danyw/IoT-LED-Controller/assets/led_controller_enclosure_2.png

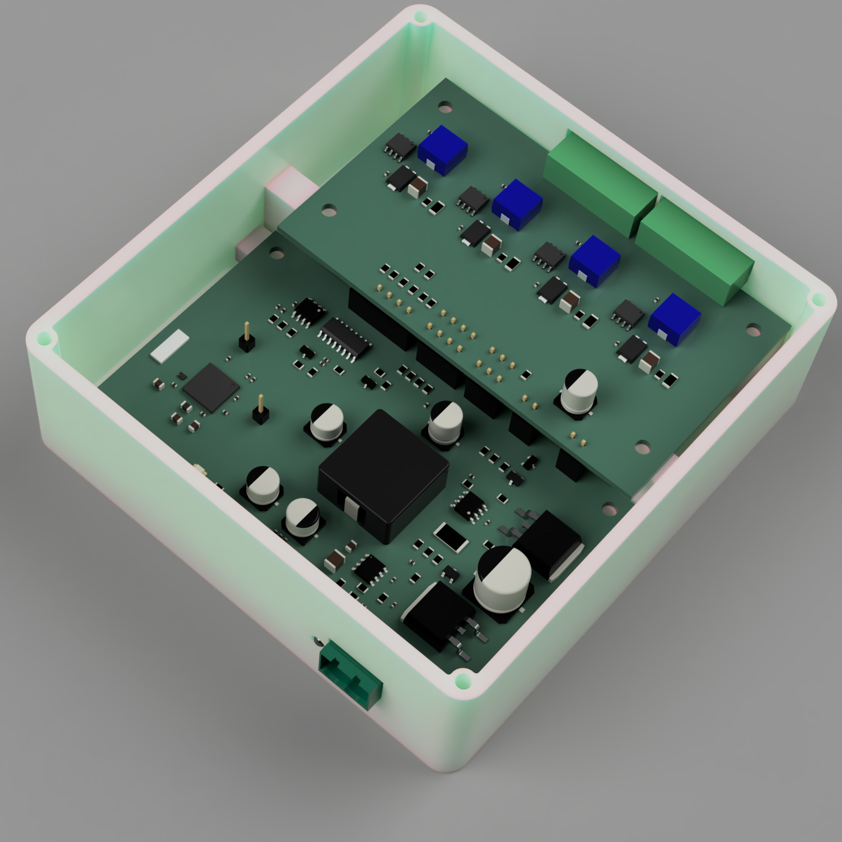
assets/led_controller_enclosure_2.png
