danyw/IoT-LED-Controller/MCU firmware/Core/Src/main.c

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
/* Includes ------------------------------------------------------------------*/
#include "main.h"
#include "adc.h"
#include "dma.h"
#include "ipcc.h"
#include "memorymap.h"
#include "rf.h"
#include "rtc.h"
#include "tim.h"
#include "usart.h"
#include "usb.h"
#include "gpio.h"

/* USER CODE BEGIN Includes */
#include "led_control.h"
#include "sensors.h"
#include "flash_storage.h"
#include "app_zigbee.h"

/* USER CODE END Includes */


/* USER CODE BEGIN PV */
SystemSettings_t SystemSettings;
uint16_t rawValues[3];

/* USER CODE END PV */

void SystemClock_Config(void);
void PeriphCommonClock_Config(void);
/* USER CODE BEGIN 0 */

// one wire debugging
int _write(int file, char *ptr, int len) {
	// this is used by uts and printf
	int i=0;
	for(i=0; i<len; i++)
		ITM_SendChar((*ptr++));
	return len;
}

//uint8_t dataToWrite[] = "testing writting/erasing flash";
//uint8_t dataToRead[100]; // Make sure this is large enough for the dataToWrite plus any null termination if used

/* USER CODE END 0 */

/**
  * @brief  The application entry point.
  * @retval int
  */
int main(void)
{
  /* MCU Configuration--------------------------------------------------------*/

  /* Reset of all peripherals, Initializes the Flash interface and the Systick. */
  HAL_Init();
  /* Config code for STM32_WPAN (HSE Tuning must be done before system clock configuration) */
  MX_APPE_Config();

  /* Configure the system clock */
  SystemClock_Config();

/* Configure the peripherals common clocks */
  PeriphCommonClock_Config();

  /* IPCC initialisation */
  MX_IPCC_Init();

  /* Initialize all configured peripherals */
  MX_GPIO_Init();
  MX_DMA_Init();
  MX_USART1_UART_Init();
  MX_USB_PCD_Init();
  MX_TIM1_Init();
  MX_TIM2_Init();
  MX_ADC1_Init();
  MX_RTC_Init();
  MX_RF_Init();
  /* USER CODE BEGIN 2 */
  HAL_ADCEx_Calibration_Start(&hadc1, ADC_SINGLE_ENDED);
  HAL_TIM_PWM_Init(&htim1);
  HAL_TIM_PWM_Init(&htim1);
  Sensors_Init(&hadc1);

  HAL_Delay(100);
  LoadSettingsFromFlash();	// load all the system settings from the flash memory
  HAL_Delay(100);

  start_led_control(&SystemSettings); // Pass the address of the settings struct to start_led_control
  HAL_Delay(20);
//store_flash_memory(FLASH_ADDRESS_STRING, (uint8_t *)char_random, sizeof(char_random));
// Write data to flash
//  if(Flash_Write(FLASH_USER_START_ADDR, dataToWrite, sizeof(dataToWrite)) != HAL_OK) {
//   //  Handle error
//  }
//


//  ReadSettingsFromFlash(&SystemSettings);	// it reads the settings from the flash memory and saves in the specified place

  // TODO DEV generating sample settings
//  generateSampleData(&SystemSettings);	// generates sample system settings, used for debugging
//  WriteSettingsToFlash(&SystemSettings);	// writes settings to flash


  // Print sample data for verification
//  SystemSettings_t settings;
//  for (int channel = 0; channel < PWM_CHANNELS_MAX; ++channel) {
//      printf("Channel %d: ", channel);
//      for (int hour = 0; hour < 24; ++hour) {
//          printf("%d ", settings.pwmx_brightness[channel][hour]);
//      }
//      printf("\n");
//  }


  /* USER CODE END 2 */

  /* Init code for STM32_WPAN */
  MX_APPE_Init();

  /* Infinite loop */
  /* USER CODE BEGIN WHILE */
  while (1)
  {

    /* USER CODE END WHILE */
    MX_APPE_Process();

    /* USER CODE BEGIN 3 */
//    if ((HAL_GPIO_ReadPin(GPIOC, GPIO_PIN_4 )) == GPIO_PIN_RESET) {
////        start_led_control(&SystemSettings); // Pass the address of the settings struct to start_led_control
////        HAL_Delay(3000);
////        stop_led_control();
//    	  }
//    HAL_Delay(500);

    if ((HAL_GPIO_ReadPin(GPIOC, GPIO_PIN_4 )) == GPIO_PIN_RESET) {
    	HAL_GPIO_TogglePin(GPIOB, GPIO_PIN_5);
    	HAL_Delay(300);
    }
  }
  /* USER CODE END 3 */
}

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
/* USER CODE BEGIN 4 */
void HAL_RTC_AlarmAEventCallback(RTC_HandleTypeDef *hrtc) {
	if (__HAL_RTC_ALARM_GET_FLAG(hrtc, RTC_FLAG_ALRAF)) {
		RTC_AlarmTypeDef sAlarm;
		HAL_RTC_GetAlarm(hrtc,&sAlarm,RTC_ALARM_A,FORMAT_BIN);
		sAlarm.AlarmTime.Seconds = (sAlarm.AlarmTime.Seconds + 10) % 60;
		while(HAL_RTC_SetAlarm_IT(hrtc, &sAlarm, FORMAT_BIN)!=HAL_OK){}

		  Sensors_Measure();	// ADC DMA start; voltage, current, temp
	}
	else if (__HAL_RTC_ALARM_GET_FLAG(hrtc, RTC_FLAG_ALRBF)) {
        // Alarm B triggered the callback
        update_led_control();
	}

}

void HAL_ADC_ConvCpltCallback(ADC_HandleTypeDef *hadc) {
	if(hadc == &hadc1) {
		float voltage = Sensors_GetVoltage(rawValues[0]);
		float current = Sensors_GetCurrent(rawValues[1]);
		float temerature = Sensors_GetTemperature(rawValues[2]);
		float power = Sensors_CalculatePower(voltage, current);
		printf("Voltage: %f V, Current: %f A, Temperature: %f C, Power: %f W\n", voltage, current, temerature, power);
	}
}

/* USER CODE END 4 */
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
