danyw/IoT-LED-Controller/MCU firmware/IoT-Controller-MCU-dev.ioc

Mcu.UserName=STM32WB55RGVx
PA0.Signal=S_TIM2_CH1
PA1.Signal=S_TIM2_CH2
PA10.Signal=S_TIM1_CH3
PA11.Signal=USB_DM
PA12.Signal=USB_DP
PA13.GPIO_Label=JTMS
PA13.Signal=SYS_JTMS-SWDIO
PA14.GPIO_Label=JTCK
PA14.Signal=SYS_JTCK-SWCLK
PA2.Signal=S_TIM2_CH3
PA8.GPIO_Label=TIM1_CH1
PA8.Signal=S_TIM1_CH1
PA9.Signal=S_TIM1_CH2
PB0.GPIO_Label=LD2 [Green Led]
PB0.Signal=GPIO_Output
PB1.GPIO_Label=LD3 [Red Led]
PB1.Signal=GPIO_Output
PB13.GPIO_Label=soft_en_24v
PB13.Signal=GPIO_Output
PB3.GPIO_Label=JTDO
PB3.Signal=SYS_JTDO-SWO
PB5.GPIO_Label=LD1 [Blue Led]
PB5.Signal=GPIO_Output
PB6.GPIO_Label=STLINK_RX
PB6.Signal=USART1_TX
PB7.GPIO_Label=STLINK_TX
PB7.Signal=USART1_RX
PC0.GPIO_Label=ADC_VOLTAGE
PC0.Signal=ADCx_IN1
PC1.GPIO_Label=ADC_CURRENT
PC1.Signal=ADCx_IN2
PC10.GPIO_Label=led_enable
PC10.Signal=GPIO_Output
PC13.Signal=SYS_WKUP2
PC14-OSC32_IN.Signal=RCC_OSC32_IN
PC15-OSC32_OUT.Signal=RCC_OSC32_OUT
PC2.GPIO_Label=ADC_TEMP
PC2.Signal=ADCx_IN3
PC4.GPIO_Label=B1 [Push Button]
PC4.Signal=GPIO_Input
PD0.GPIO_Label=B2 [Push Button]
PD0.Signal=GPIO_Input
PD1.GPIO_Label=B3 [Push Button]
PD1.Signal=GPIO_Input
