danyw/IoT-LED-Controller/Coordinator MCU firmware/Core/Inc/main.h

#define LD1_Pin GPIO_PIN_4
#define LD1_GPIO_Port GPIOA
#define LD2_Pin GPIO_PIN_0
#define LD2_GPIO_Port GPIOB
#define LD3_Pin GPIO_PIN_1
#define LD3_GPIO_Port GPIOB
#define B1_Pin GPIO_PIN_10
#define B1_GPIO_Port GPIOA
#define JTMS_Pin GPIO_PIN_13
#define JTMS_GPIO_Port GPIOA
#define JTCK_Pin GPIO_PIN_14
#define JTCK_GPIO_Port GPIOA
#define JTDO_Pin GPIO_PIN_3
#define JTDO_GPIO_Port GPIOB
