danyw/IoT-LED-Controller/(commit log)

2023-12-08 add basic LED function
2023-12-08 add led functions done
2023-12-09 add adc with DMA and callback
2023-12-10 add sensors calculations
2023-12-14 add led start
2023-12-30 Frontend: add LED profiles, spectrum chart
2023-12-30 add led profiles
2024-01-09 frontend: add ledControl API backend: add ledControl controller
2024-06-23 add led profiles schema
